LucasSantosv/servo-inteligente-rp2040/README.md

# Servo inteligente experimental com RP2040

Protótipo de baixo custo para o robô pato: começou com motor DC TT com redutor e avançou para um servo ST47 com motor original e controle externo. A bancada usa posição por potenciômetro, ponte MX1508, PID, medição ACS712 e temperatura por NTC. O objetivo é estudar um atuador acessível; arquitetura final, PCB e lote de 20 unidades continuam em avaliação.

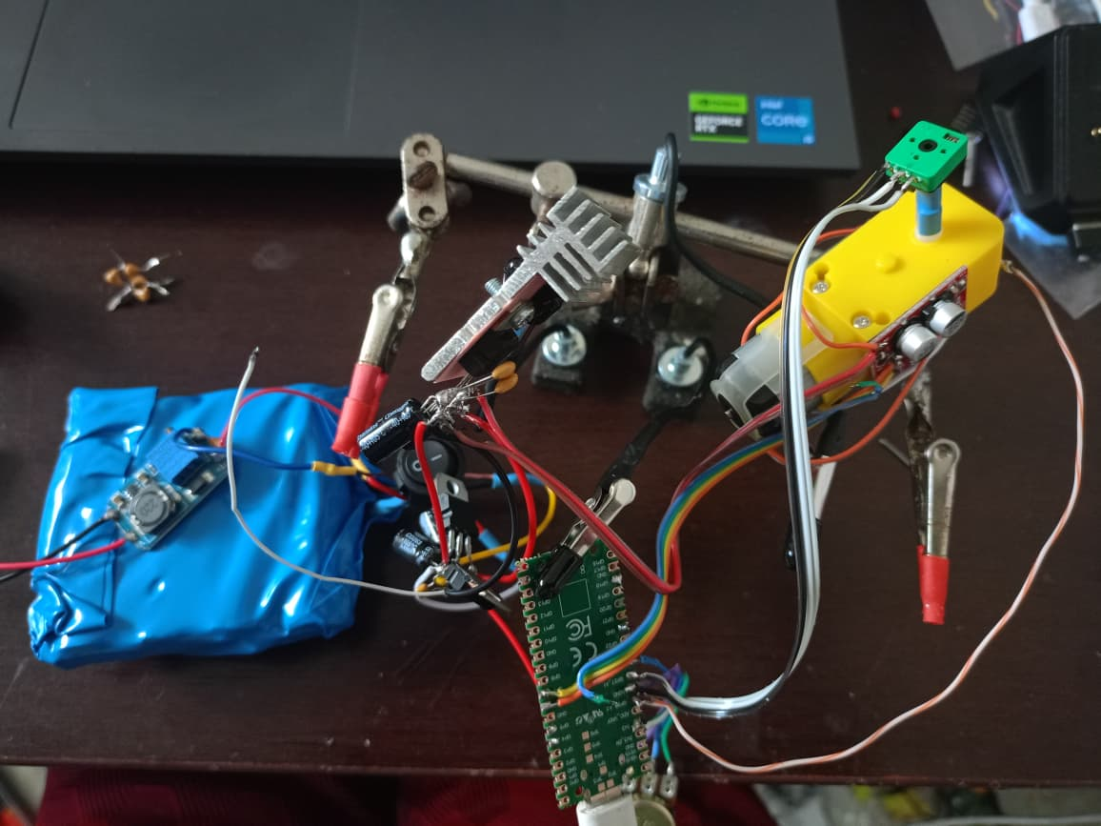
[picture p1: media/2026-10-31/foto_05.jpeg]
Montagem inicial do protótipo


## Avanço mais recente — servo convertido e perfis de PID (01/11/2026)

O autor substituiu o TT por um servo ST47 com seu motor original e relatou bons resultados iniciais. A V16 permite comparar dez perfis de PID pelo Serial, mantendo a V15 disponível. A velocidade em relação ao controle original ainda está em investigação; não há calibração física do novo potenciômetro nem tensão confirmada deste ensaio.

### Vídeo do funcionamento

Registro de bancada com o servo ST47 e controle externo, enviado pelo autor em 01/11/2026. Vídeo completo, sem cortes ou recompressão: 26,5 s, MP4/H.264, 848 × 478, aproximadamente 6,3 MB. Áudio original preservado.

https://github.com/user-attachments/assets/62a6422f-c1e9-4013-8bb7-1cb3dd7c559f

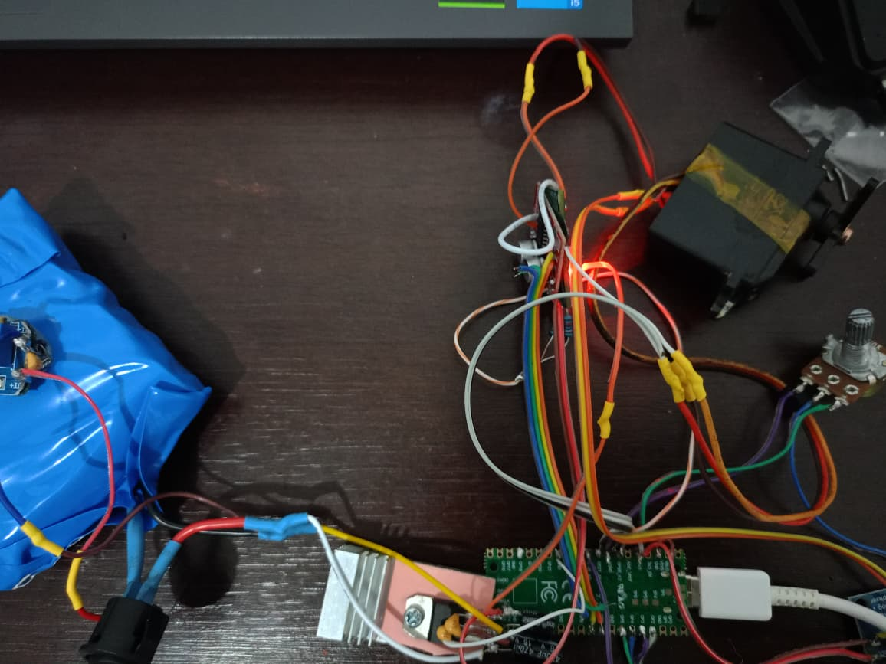
[picture p2: media/2026-11-01/01-montagem-servo-st47.jpeg]
Montagem com servo convertido


[Relato, telemetria e limites da observação](docs/avanco-2026-11-01.md) · [Duas imagens originais](media/2026-11-01/) · [V16 e tabela dos perfis](firmware/atual/teste_servo_v16_perfis_pid/LEIA-ME.md)

## Ensaio anterior com TT — bancada em 7,5 V (31/10/2026)

O autor relatou **cinco minutos de teste extremo a 7,5 V**. As capturas mostram aquecimento da carcaça de 48,6 °C no início do trecho visível até **51,4 °C**, com leituras finais entre 51,3 e 51,4 °C. Esse intervalo não é o início completo do teste nem prova equilíbrio térmico.

[Relatório e limites da observação](docs/ensaio-termico-2026-10-31.md) · [Capturas originais](media/2026-10-31/ensaio-termico/)

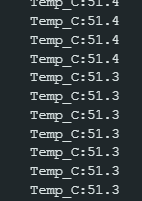
[picture p3: media/2026-10-31/ensaio-termico/02-temperatura-final.png]
Trecho final da temperatura


É uma observação funcional de bancada, não validação de uso contínuo, torque ou tensão máxima. A leitura do NTC usa a curva configurada de 100k/B3950, ainda sem calibração independente. ACS_OK=1, mas ESCALA=0/Amp_OK=0: existe leitura em mV, **não corrente calibrada em amperes**. Não há CSV completo desse ensaio publicado.

## Firmware atual

Use a [V16 com perfis PID](firmware/atual/teste_servo_v16_perfis_pid/LEIA-ME.md). A [V15 BANCADA-CARGA](firmware/atual/teste_tt_v15_bancada_carga/COMECE_AQUI.md) permanece disponível no mesmo caminho.

1. Abra [teste_servo_v16_perfis_pid.ino](firmware/atual/teste_servo_v16_perfis_pid/teste_servo_v16_perfis_pid.ino), mantendo os seis arquivos .h juntos. Compilado para Raspberry Pi Pico, Arduino-Pico 6.0.0; confirme a variante física da placa.
2. Monitor Serial em **115200**, colunas fixas a 1 Hz. **p**: B10K suave. **f**: B10K rápido, permite PWM até ±255. **x**: parar.
3. **0–9**: selecionar perfil sem iniciar o motor; **0** mantém ganhos V15. **k**: mostrar os ganhos atuais. A tabela completa está no guia da V16.
4. **g**: Plotter PID. **h**: Plotter sensores. **l**: Monitor. **c**: coleta D15 compatível com o gravador anterior, sem identificação do perfil. **?**: ajuda.
5. ACS712: **z** para parar e zerar; **a1/a2/a3** para variantes 5/20/30 A, somente se identificadas; **a0** para variante desconhecida. Esses comandos mudaram na V16 porque os números agora selecionam PID.

Os ganhos são experimentais; os perfis não são níveis crescentes de potência. O FF permanece ativo. [Verificação da V16](firmware/atual/teste_servo_v16_perfis_pid/VALIDACAO.md) · [Validação anterior](docs/validacao.md).

**BANCADA-CARGA:** sem movimento, o PID continua podendo aplicar potência. SEM_MOV=1 e ESTADO=5 são avisos. Permanecem os cortes externos de posição, atraso do controle, parada por x e perda do Serial, além da verificação inicial de sentido. Não há corte por corrente ou temperatura. A V7 anteriormente publicada permanece no caminho antigo para preservar os links; é uma revisão anterior, não a versão atual.

## Ligações atuais

| Função | Ligação |
|---|---|
| CD74HC4067 VCC / GND / EN | 3V3 / GND / GND |
| MUX S0 / S1 / S2 / S3 | GP2 / GP3 / GP4 / GP5 |
| MUX SIG/COM | GP26 |
| C0 | Cursor B10K; extremos 3V3/GND |
| C1 | Junção do divisor: 3V3 → resistor fixo 4,7k → C1 → NTC 100k → GND |
| C2–C15 | Reservados; ainda não lidos |
| Potenciômetro de posição do conjunto em teste | Cursor GP27; extremos 3V3/GND |
| ACS712 OUT | Divisor 10k/10k ao GP28; sensor alimentado em 5 V, GND comum |
| MX1508 IN1 / IN2 | GP6 / GP7 |
| Motor DC do conjunto em teste | Saída A da ponte |
| Servo normal opcional | Sinal GP18, fonte adequada e GND comum |

GP indica GPIO, não número físico do conector. A fonte do motor alimenta a ponte pelo caminho ACS IP+ → IP−; o retorno de potência vai à fonte, com GND comum ao RP2040. Não aplicar 5 V às entradas ADC ou aos canais do multiplexador. Nunca alimentar motor pelo 3V3.

O NTC está configurado conforme o programa da extrusora: 100k a 25 °C, Beta 3950, resistor fixo 4,7k. A inscrição de curso de 216° no potenciômetro do teste com TT foi informada pelo autor; a escala do potenciômetro do ST47 convertido ainda precisa ser verificada. O firmware assume ADC 0–4095 = 0–216°, com comando nominal de 18–198°; isso não demonstra 180° físicos calibrados.

## Gravação e análise

[Gravador de Testes V3 para Windows](tools/GravadorDeTestesV3/COMECE_AQUI.md): executável, código-fonte e prévia com dados fictícios. Reconhece V13/V14/V15, cria nomes por data/modo/versão e salva CSV, registro bruto e resumo. Feche o Monitor/Plotter antes de usar a mesma porta no gravador.

O gravador foi compilado e testado com dados sintéticos; isso é separado do teste físico do firmware feito pelo autor. Na coleta completa, ESTADO=5 registra o aviso de falta de progresso. As variantes V15 compartilham a identificação; consulte a pasta do sketch gravado para distinguir a variante.

## Histórico e próximos passos

- [Avanço com ST47 e perfis PID — 01/11/2026](docs/avanco-2026-11-01.md)
- [Evolução dos testes](docs/testes-2026-10-31.md)
- [Códigos anteriores, incluindo tentativas que falharam](firmware/historico/)
- [Validação e testes reproduzíveis](docs/validacao.md)
- [Fotos da primeira montagem e capturas](media/2026-10-31/README.md)
- [Arquitetura e opções futuras](docs/arquitetura-e-proximos-passos.md)

Encoder magnético de 360°, DRV8876, comunicação entre atuadores, um controlador por servo versus controle centralizado e PCB para 20 unidades são opções futuras. O protótipo físico atual usa **MX1508**, não DRV8876. Ainda não foram definidos torque útil, precisão, vida útil, custo final ou licença de distribuição.
