LucasSantosv/servo-inteligente-rp2040/media/2026-11-01/README.md

# Registro de 01/11/2026

- [Montagem com servo ST47](01-montagem-servo-st47.jpeg): foto original enviada pelo autor.
- [Monitor Serial/PID](02-telemetria-pid.png): captura original enviada pelo autor.

[Contexto, resultados relatados e limitações](../../docs/avanco-2026-11-01.md).

## Vídeo do funcionamento

Vídeo original enviado pelo autor: 26,5 s, MP4/H.264, 848 × 478, aproximadamente 6,3 MB. Preservado sem cortes ou recompressão; hospedado como anexo do GitHub.

https://github.com/user-attachments/assets/62a6422f-c1e9-4013-8bb7-1cb3dd7c559f

SHA-256 do arquivo original: `862b402ce49de3a58c50de79a473ce87fe3b8c283ca17b2df0964512ab40738c`.
