LucasSantosv/servo-inteligente-rp2040/media/2026-10-31/ensaio-termico/README.md

# Capturas do ensaio térmico a 7,5 V

Originais fornecidos pelo autor, sem edição. Cinco minutos de teste extremo relatados; o tempo integral não aparece nas imagens.

- [01 — telemetria e aquecimento](01-telemetria-aquecimento.png): recorte com temperatura em torno de 48,6 a 50,1 °C, posição, alvo, PID, PWM e estados dos sensores.
- [02 — temperatura final](02-temperatura-final.png): valores entre 51,3 e 51,4 °C; máxima visível de 51,4 °C.

[Relatório com condições e limitações](../../../docs/ensaio-termico-2026-10-31.md). Não é possível inferir estabilização térmica ou corrente em amperes desses recortes.
