LucasSantosv/servo-inteligente-rp2040/media/2026-10-31/foto_02.jpeg

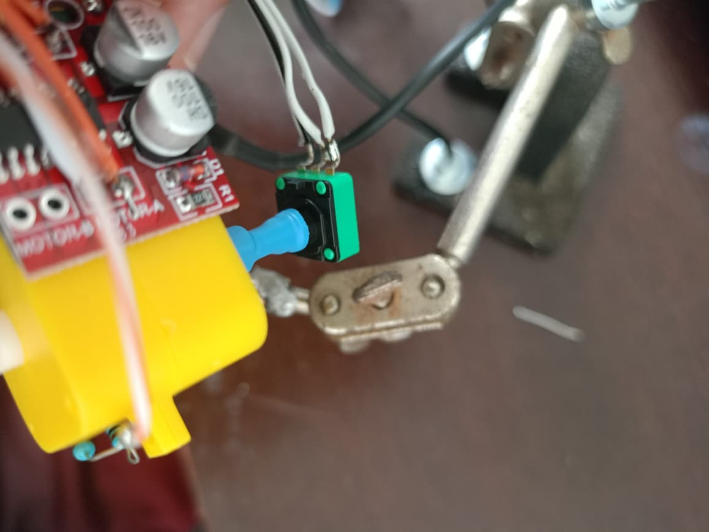
media/2026-10-31/foto_02.jpeg
