LucasSantosv/servo-inteligente-rp2040/media/2026-10-31/foto_03.jpeg

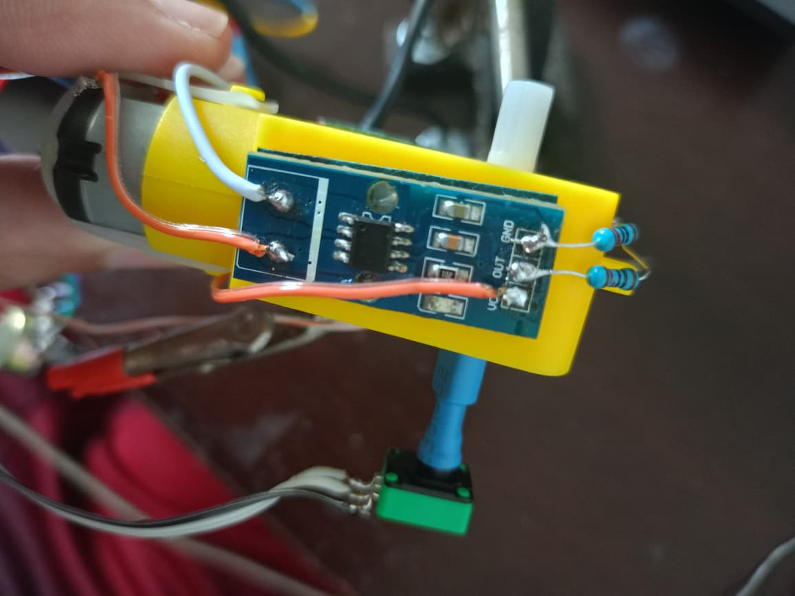
media/2026-10-31/foto_03.jpeg
