LucasSantosv/servo-inteligente-rp2040/media/2026-10-31/serial_01_acs_saturado.png

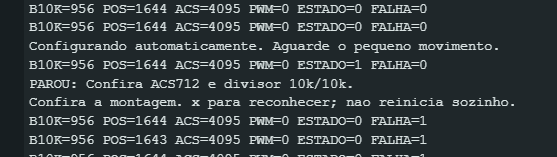
media/2026-10-31/serial_01_acs_saturado.png
