LucasSantosv/servo-inteligente-rp2040/media/2026-10-31/serial_02_acs_estavel_sem_movimento.png

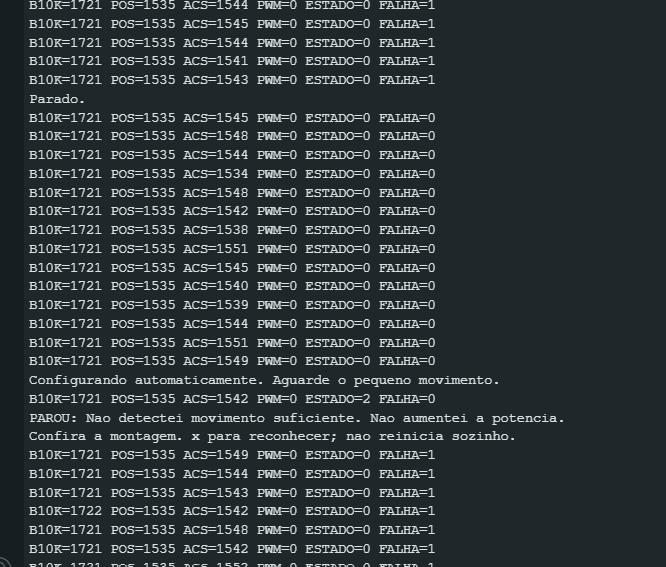
media/2026-10-31/serial_02_acs_estavel_sem_movimento.png
