LucasSantosv/servo-inteligente-rp2040/docs/testes-2026-10-31.md

> O trecho inicial abaixo foi publicado na etapa V7 e está preservado como histórico. A versão atual é V15 BANCADA-CARGA; ver a atualização ao final e o README da raiz.

# Diário experimental — 31/10/2026

Este registro distingue relato do usuário, captura do Serial, compilação e
validação física. Não transforma uma compilação em prova de funcionamento.

## Montagem

O plano inicial previa aproveitar motor e potenciômetro de um MG995. O usuário
consertou esse servo e passou a usar um motor TT para simular um atuador com
retorno de posição. Informou acoplamento direto ao potenciômetro. As cinco
fotos recebidas mostram o conjunto mecânico, a placa RP2040, a ponte e a
montagem de alimentação. A ponte MX1508 já havia sido usada no projeto da
antena; para este teste, foi informado o canal A e 5 V na entrada.

## Evolução e resultados observados

| Etapa | Evidência e resultado |
|---|---|
| Primeiros códigos conjuntos | Servo comum no GP18, B10K no GP26, retorno GP27 e ACS GP28. Sem validação física completa. |
| Teste com ACS712 | Captura mostra `ACS=4095`; o programa bloqueou antes de mover. |
| Ligação de GND do ACS | Usuário encontrou o terra desconectado. Após conectar, captura mostra ACS perto de 1540–1550. Isso valida uma leitura de repouso plausível, não corrente calibrada. |
| Primeira detecção automática | `POS` ficou em torno de 1535; programa informou falta de movimento. Usuário confirmou TT parado. |
| V2/V3 | Intensidade de partida foi aumentada de 25% para 44% e depois 78%; duração foi alterada de 15 para 50 ms. Não houve comprovação de vai e vem. |
| V4 sem ACS | Usuário pediu ignorar o sensor e depois relatou que o motor girou, mas deu apenas um pulso. Isso confirma movimento inicial, não funcionamento de servo fechado. |
| V5 | Teto de partida de um segundo e maior deslocamento permitido na detecção; compilado. Não há registro suficiente para afirmar movimento contínuo dessa revisão. |
| V6 | Exigia A/B físicos de 180° e eixo no meio. A captura mostra B em 3550 e `ANG=?`, seguido de bloqueio por calibração. Pode faltar A ou haver um par inválido; a captura não mostra um A válido. A exigência tornou o teste difícil. |
| V7 | Corrige o início: sem dois pontos manuais válidos, cria um arco pequeno centrado na posição atual. Teste cobre B isolado em 3550 e POS3550. Compilado; teste físico ainda pendente. |

## O que ainda não foi demonstrado

- Vai e vem contínuo de 180° reais, repetibilidade angular ou estabilidade.
- Resposta sob carga, torque, corrente em partida/travamento ou dissipação.
- Sintonia PID, proteção de corrente ou firmware de atuador pronto para robô.
- Operação simultânea validada do servo comum e do TT.

A oscilação automática da V7 usa ADC e mostra percentual. O ângulo físico
exige conhecer o curso do sensor ou uma medição externa. Não é apropriado
buscar os batentes do potenciômetro com o motor para tentar descobri-lo.

Os códigos anteriores foram preservados em `firmware/historico/`, incluindo
seus arquivos de validação originais, como registro do desenvolvimento. Use
o firmware atual como entrada para novos testes; não trate todas as revisões
como intercambiáveis.

## Atualização — V8 a V15 e ensaio térmico

- V8: usuário relatou movimento funcionando com a hipótese de potenciômetro de 216° e arco nominal de 180°. Não houve calibração angular externa.
- V9: introdução de PID/perfil suave; usuário relatou paradas e força insuficiente perto de uma posição. Não registrar essa revisão como funcional sob toda a carga.
- V10: alteração do PWM para modo de acionamento/frenagem da MX1508 e ajuste da potência perto das pontas; notas de compilação preservadas na pasta da revisão.
- V11: modos p (B10K suave) e f (rápido, até 100% PWM), velocidade e pico estimados pelo potenciômetro.
- V12: curvas PID no Plotter. Foi posteriormente identificada a limitação de oito curvas na IDE 2.
- V13: ACS712 reintegrado, zero por z e escala 5/20/30 A selecionável; versão física do ACS ainda não identificada.
- V14: CD74HC4067, B10K no C0, NTC no C1, retorno de posição GP27 e corrente GP28 diretos; coleta completa para o gravador.
- V15: após relato de oscilação a 7,5 V, D do modo f reduzido de 1,8 para 1,0; modo p preservado. Simulações não substituem validação física.
- Variante Monitor lento: texto em colunas fixas a cada segundo; controle, Plotter e coleta mantêm suas frequências.
- Início recusado com posição indicada em 7,8°: a leitura estava perto da ponta; usuário confirmou que esse era o impedimento. Não se tratava de botão de reprodução.
- NTC: resistor fixo desconectado foi identificado e recolocado. O usuário relatou compra do NTC junto aos da extrusora; o firmware usa 100k/B3950/4k7 conforme o código desse projeto, ainda sem calibração independente.
- Variante BANCADA-CARGA: falta de progresso durante controle gera aviso, sem travar o PID, conforme pedido de simulação de carga. Outros cortes permanecem. Usuário enviou capturas V15 operando, mas as imagens não distinguem inequivocamente todas as variantes V15.
- Ensaio de cinco minutos de teste extremo, a **7,5 V**, informado pelo autor: temperatura máxima visível de **51,4 °C** na carcaça; ACS com zero aceito e sem escala em amperes. [Relatório e capturas](ensaio-termico-2026-10-31.md).

O ponto atual é um protótipo funcional em evolução. Ainda faltam torque medido, curva de corrente calibrada, identificação do motor, repetibilidade angular, regime térmico contínuo, durabilidade e operação no robô.
