LucasSantosv/servo-inteligente-rp2040/firmware/historico/teste_servos_juntos/VALIDACAO.md

# Verificacao em 31/10/2026

- Compilacao final: APROVADA para rp2040:rp2040:rpipico, Arduino-Pico 6.0.0.
- Codigo: 63.700 bytes. Variaveis globais: 9.256 bytes.
- Biblioteca Servo: incluida no pacote Arduino-Pico, geracao de pulsos por PIO.
- Revisao estatica: GPIOs distintos; ponte com inicializacao desligada;
  troca de sentido desligando primeiro a entrada oposta; comando x;
  calibracao de posicao; verificacao limitada de sentido; corte por ACS,
  falta de progresso e posicao fora de faixa; ambos desligados apos reset.
- Sem testes de bancada, gravacao ou confirmacao da variante fisica RP2040.
- ACS712 sem variante identificada: leitura em ADC/volts, sem amperes.
- PID ainda sem ajuste fisico: apenas P ativo, PWM limitado a 25%.
- O erro inicial de DLL do Windows foi contornado executando o compilador
  instalado fora do ambiente restrito. A compilacao final terminou com codigo 0.

Este resultado confirma compilacao, nao compatibilidade eletrica/mecanica,
capacidade da MX1508 para o MG995 ou qualidade do controle em carga.
