LucasSantosv/servo-inteligente-rp2040/media/2026-10-31/serial_03_v6_bloqueio_calibracao.png

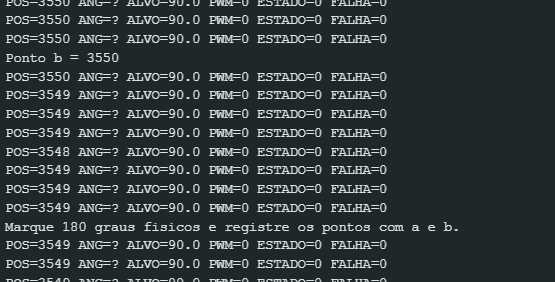
media/2026-10-31/serial_03_v6_bloqueio_calibracao.png
