LucasSantosv/servo-inteligente-rp2040/tools/GravadorDeTestesV3/PREVIA.png

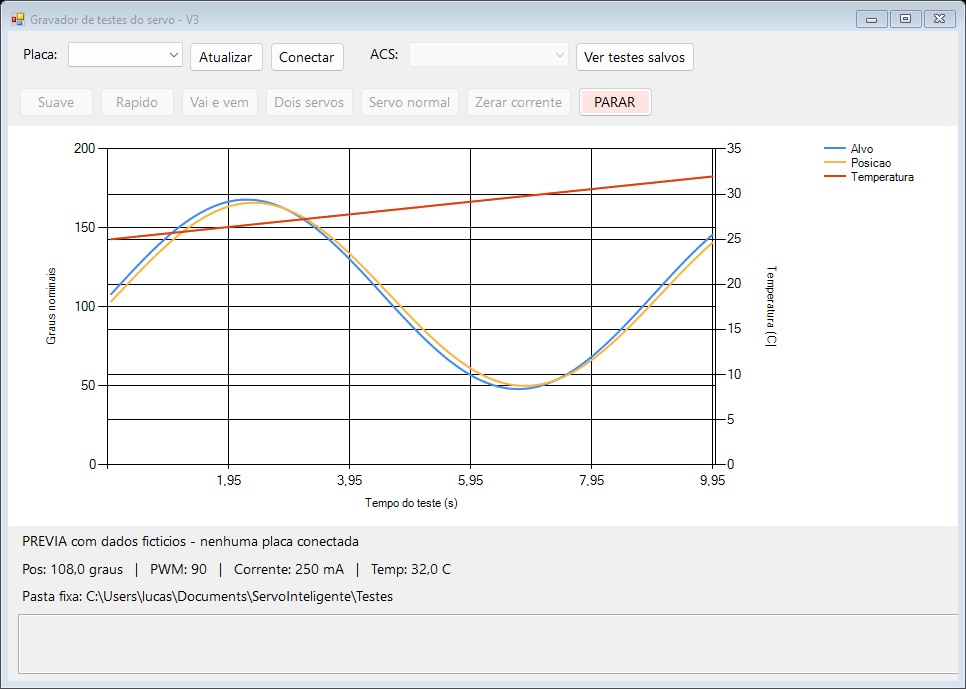
tools/GravadorDeTestesV3/PREVIA.png
