LucasSantosv/servo-inteligente-rp2040/(commit log)

2026-11-01 Registra V15, gravador e ensaio termico de cinco minutos a 7,5 V
2026-11-02 Registra teste com ST47, fotos de 01/11 e firmware V16 com perfis PID
2026-11-02 Adiciona vídeo do funcionamento do ST47 no README e no diário de bancada
